adamzend/CAN-HUB/assets/rpi5-ili9341-wiring.png

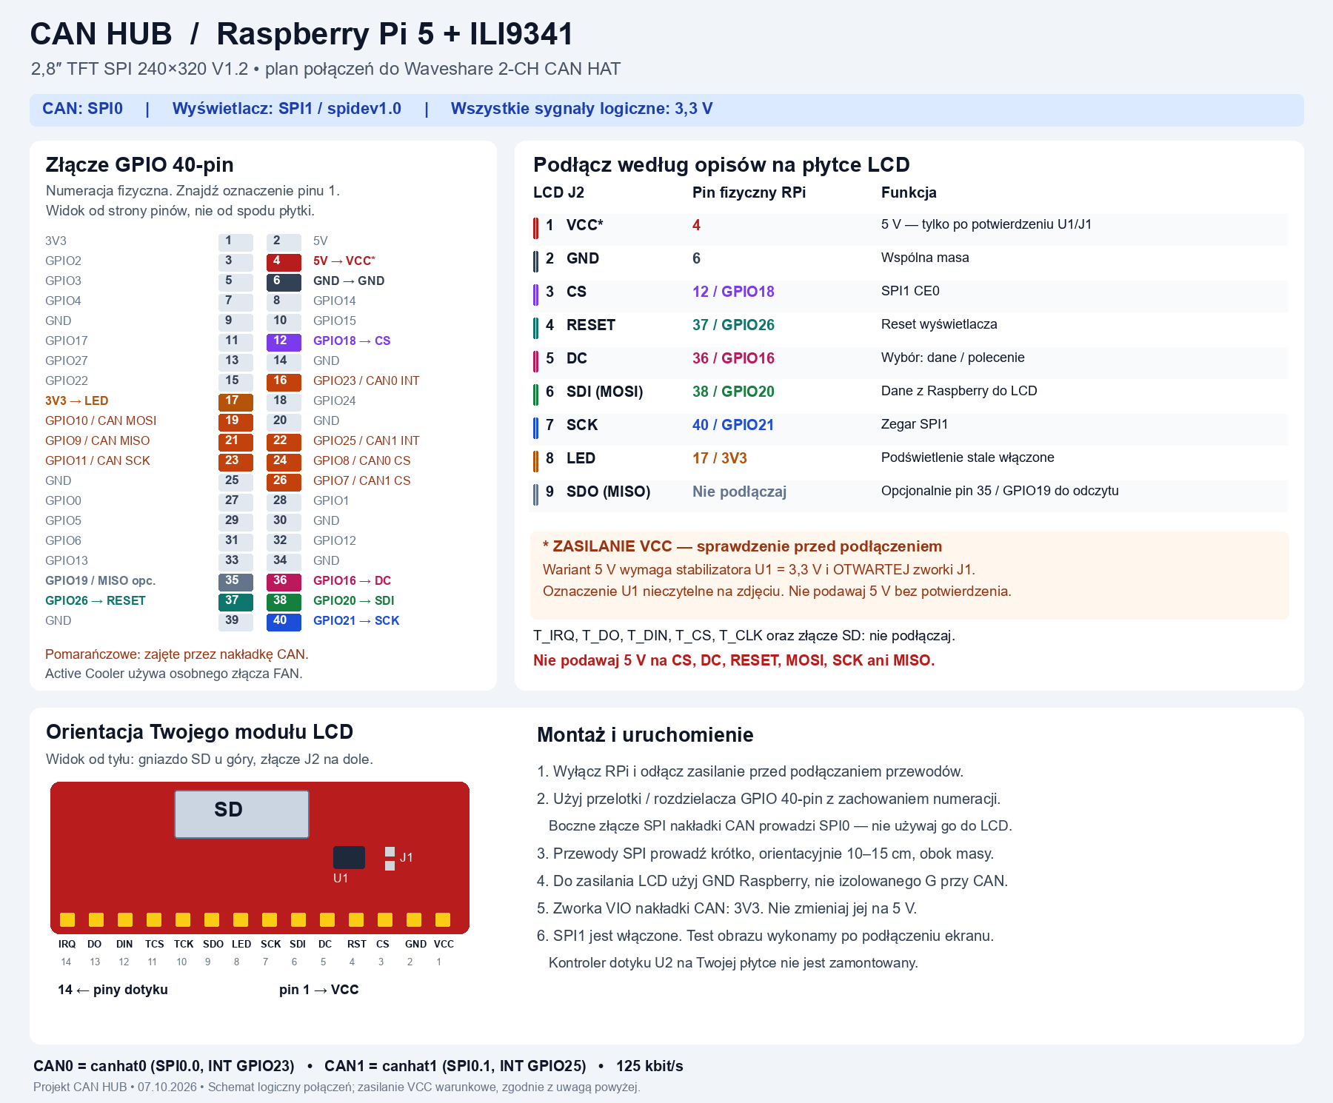
assets/rpi5-ili9341-wiring.png
