adamzend/CAN-HUB/(commit log)

2026-11-05 Publish runnable CAN HUB source, ESP32 library and installation guides
2026-11-05 Record successful ESP32 three-value example build
